HumbertoL/CoffeePotSensor/docs/HARDWARE.md

# Hardware Notes

This is everything known so far about the physical build: the parts, how they're wired and powered, and the plans for the next version. Anything not confirmed is marked *(unverified)*.

## Physical setup

As installed on 2026-10-14 (from the user's photos):

- **The pots:** three **BUNN airpots** (pump-action, with a lever on top), labeled **MEDIUM, DARK, DECAF from left to right**. They sit in a BUNN wire rack on the counter, against a tiled wall.
  - **Coffee is pumped out, so the pots stay on the rack while people pour.** A pot only leaves the rack to be refilled at the brewer, or to be cleaned. So any placement is a fresh pot (or one put back after cleaning), and no "minimum time off the rack" rule is needed.
  - **Cleaning happens after hours.** Putting a cleaned pot back looks exactly like a fresh pot, which is why the Slack messages only go out during the day (see README.md).
- **The device:** case v2 (`case/v2/`), mounted on the **wall behind the pots** (Velcro on the flat backs).
  - **Sensor bar:** low on the wall, just above the rack, behind the pots. Each sensor faces forward at the back of its pot, with its LEDs sticking out through the cover.
  - **Mast:** up the middle, behind the center pot. Its middle joint is wrapped in black tape.
  - **Head:** above the center pot, between the pump levers, at about eye level for someone at the counter. The screen's rows read Medium, Dark, Decaf top to bottom, matching the pots left to right.
  - **Power:** a USB-C cable out of the head's left side to a USB charger in the outlet to the left of the pots.
- **Wi-Fi:** right after install the screen showed the **offline** icon, but the board was online later that day (its first Slack post went out at 11:41 on 2026-10-14). ThingSpeak's `field5` (RSSI) shows the signal at that spot.

## Display: Waveshare 2inch LCD Module

[Wiki](https://www.waveshare.com/wiki/2inch-LCD-Module)

| | |
|---|---|
| Panel | IPS, 240×320, 262K colors |
| Driver | ST7789VW |
| Interface | 4-wire SPI (write-only, no MISO) |
| Operating voltage | 3.3 V or 5 V |
| Display area | 30.60 × 40.80 mm |
| Pixel pitch | 0.0975 mm |
| Module size | 58.0 × 35.0 mm, with standoffs at the four corners |
| Connectors | 8-pin header and an 8-pin cable connector, both carrying VCC, GND, DIN, CLK, CS, DC, RST, BL |

**How the firmware drives it** (`LCD_Driver.cpp`):
- **Orientation:** landscape, 320 × 240. The init command `0x36 = 0xA0` rotates the panel.
- **Color format:** 16-bit RGB565 (`0x3A = 0x05`).
- **Color inversion:** turned on (`0x21`). IPS panels need this for colors to come out right.
- **Backlight:** dimmed with PWM, set to `80`/255 (`BACKLIGHT` in `ui.cpp`).
- **SPI mode:** mode 3 at 20 MHz (`LCD_SPI_HZ` in `ui.cpp`). The ST7789 itself can go faster than that.
- **Drawing:** the code doesn't keep a copy of the screen in memory. Every pixel is written straight to the display.

## Microcontrollers

### Arduino Nano (retired)

No longer supported as of 2026-10-12. The notes below and the Nano wiring sections are kept as a record of the old build.

- The board is a **RobotDyn Nano V3**, a clone with a micro-USB port.
- ATmega328P chip at 16 MHz, with 2 KB of RAM and 32 KB of flash.
- Its pins run at 5 V, but the display expects 3.3 V. This is out of spec, but it works in practice.
- Its bootloader is unknown. Clones like this often have the old Nano bootloader, but this one isn't verified. That's why the idle restart avoids a watchdog reset; see CLAUDE.md.

### Waveshare ESP32-S3-Zero (current)

[Wiki](https://www.waveshare.com/wiki/ESP32-S3-Zero). It's also sold as the "ESP32-S3 Mini Development Board".

- **Chip:** ESP32-S3FH4R2, a dual-core 240 MHz processor with 4 MB of flash, 2 MB of PSRAM, Wi-Fi and BLE 5.
- **Size:** 18 × 23.5 mm board, with a 1.7 mm thick PCB. It comes without headers; solder on two 9-pin male strips at the standard 2.54 mm pitch.
- **USB:** native USB-C only, with no USB-to-serial chip. To force download mode, hold **BOOT** while plugging it in.
- **Pins are 3.3 V only and not 5 V tolerant.**
- **3V3(OUT):** this pin is fed by the onboard regulator, rated for up to 800 mA.
- **5V pin:** this is the USB 5V, passed straight through. It's an output when the board runs on USB, or an input if the board is powered from it instead. **In this project nothing connects to it.** The sensors and the LCD run on 3V3, and 5V must never reach a GPIO.
- **Onboard RGB LED:** a WS2812 on GPIO21.
- **Header pins vs. solder pads:** only some GPIOs are on the edge headers. As printed on the board, viewed face up with the USB-C on the right:
  - **Top edge**, left to right: 6, 5, 4, 3, 2, 1, 3V3, GND, 5V.
  - **Bottom edge**, left to right: 7, 8, 9, 10, 11, 12, 13, RX (43), TX (44).
  - **Solder pads only:** GP14–16 on the front; GP17, 18, 38–42 and 45 on the back.
- **Avoid:** GPIO0 and GPIO3 (they affect how the chip boots), 21 (the RGB LED), and 43/44 (the serial port).

## Wiring

| Signal | Nano | ESP32-S3-Zero |
|---|---|---|
| LCD VCC | 5V | 3V3(OUT) |
| LCD GND | GND | GND |
| LCD DIN (MOSI) | D11 | GPIO11 |
| LCD CLK (SCK) | D13 | GPIO12 |
| LCD CS | D10 | GPIO10 |
| LCD DC | D7 | GPIO9 |
| LCD RST | D8 | GPIO8 |
| LCD BL | D9 (PWM) | GPIO7 |
| Medium sensor OUT | D2 | GPIO4 |
| Dark sensor OUT | D3 | GPIO5 |
| Decaf sensor OUT | D4 | GPIO6 |
| Sensor VCC | 5V | **3V3 only** |
| Sensor GND | GND | GND |

On the ESP32-S3-Zero, all of these pins are on the edge headers, so none of the solder pads are needed. The display connects along the bottom edge (GP7–12). The sensors connect along the top edge (GP4–6), which also has 3V3 and GND.

### Swapping the Nano for the ESP32-S3-Zero (test)

ESP32-S3-Zero test wiring

This test reuses every wire from the current Nano build (see the next section) and only moves their ends.
- **Display:** the ribbon stays plugged into the LCD.
- **Sensor signals:** the three single wires move to GP4–6.
- **Power:**
  - The board has only one 3V3 pin and one GND pin, so power goes through the **Porcupine board** (below).
  - One female-to-female jumper runs from each ESP32 power pin to its rail, and everything that needs power plugs into the rail.
  - The white sensor wire moves from the Nano's 5V to the **3V3 rail**.

**Steps**
1. Solder the two 9-pin headers, with the pins pointing away from the BOOT/RESET buttons.
2. Move the wires as shown in the diagram. Two colors appear twice:
   - **Ribbon blue and yellow** go to the LCD: RST on GP8 and CLK on GP12.
   - **Single blue and yellow wires** go to the sensors: GP4 and GP5.
3. Leave **5V** empty. The IR modules pull their output up to their own supply, so on 5V they would put 5 V on GP4–6.
4. Flash the firmware over USB-C with board `esp32:esp32:waveshare_esp32_s3_zero`. If no `/dev/cu.usbmodem*` port appears, hold **BOOT** while plugging in.
5. Open the serial monitor at 115200 baud. Expect `[BOOT] Starting CoffeePot Monitor...`.
6. Check the screen:
   - The title and three rows appear.
   - Pots already present show **Unknown**.
   - A lifted pot shows **Removed** after about 3 seconds.
   - A pot put back starts its timer after about 1 second.
7. If detection got worse, re-tune each sensor's sensitivity screw. They have a shorter range at 3.3 V.

Expected draw on 3V3 is roughly 100–150 mA (backlight plus three sensors), well within the regulator's rating.

### Spider board (case v2)

In case v2, sensor power is split in the bar instead of the head, so only 5 wires go up the mast: 3 signals, 3V3 and GND.
- **What it is:** a second helper board in the bar, the "spider board".
- **Size:** 20 × 16.1 × 1.5 mm.
- **Pins:** two rows of 5 right-angle pins, one row per rail, pointing out of opposite ends.
- **3V3 row:** the mast's 3V3 plus each sensor's VCC.
- **GND row:** the mast's GND plus each sensor's GND.
- **The Porcupine board** in the head then feeds only the ESP32, the LCD and the mast.

See [case/v2/README.md](../case/v2/README.md).

### Porcupine board (power distribution)

This is a small helper board that turns the ESP32's single 3V3 pin and single GND pin into two 6-pin rails.
- **Construction:** a spare piece of prototype board, 13.8 mm wide (across the pin rows) × about 20 mm long, with two mounting holes.
- **Pins:** two rows of 6 male header pins on the top side.
- **Rails:** on the bottom, each row is soldered together into one rail, 3V3 or GND. All the wires already end in Dupont female housings, so nothing has to be cut.

| Rail | Pin 1 | Pin 2 | Pin 3 | Pins 4–6 |
|---|---|---|---|---|
| 3V3 | jumper from the ESP32's 3V3 | red (LCD VCC) | white (sensor VCC, via the existing lever connector) | spare |
| GND | jumper from the ESP32's GND | brown (LCD GND) | black (sensor GND, via the existing lever connector) | spare |

The spare pins fit each sensor's own VCC and GND, if the sensors are later taken off the lever connectors.

**Before first power-up:**
- Check with a multimeter that each rail is continuous across all 6 pins, and that the two rails aren't connected to each other.
- Mark the 3V3 rail. Swapping the rails would power the sensors and the LCD backwards.

**Future case work:** the case has no mount for this board yet. The redesigned brain box should include one.

## Old Nano build: wire colors (for reference)

This is the wiring as it is today, read from photos of the open case (October 2026) and checked against the pin assignments in the code. Each row says how it was determined:
- **Code + photo:** the photo clearly shows the wire on that pin, and it matches the code.
- **Photo:** traced in the photos, and consistent with the code, but not certain.
- **Builder:** confirmed by the person who wired it.
- **Inferred:** worked out from what's left over. Check with a continuity tester before relying on it.

### Board and connections

- **Board:** a RobotDyn Nano V3 (ATmega328P) mounted upside down, taped inside the center body.
- **Power:** a white micro-USB cable.
- **Connections:** all wires use individual Dupont female jumper housings on the Nano's headers. Nothing is soldered.
- **Sensor power:** it's shared through two orange-lever splice connectors, WAGO-style.

### Display (8-wire rainbow ribbon)

At the LCD end, the ribbon plugs into the module's 8-pin header with a single housing. The module's white cable connector is unused. Read top to bottom at the LCD, the colors are red, brown, orange, yellow, green, purple, blue, gray. That matches the header order VCC, GND, DIN, CLK, CS, DC, RST, BL.

| LCD pin | Wire | Nano pin | Source |
|---|---|---|---|
| VCC | red | 5V (analog-side row) | Code + photo |
| GND | brown | GND (digital-side row, next to RST) | Photo |
| DIN | orange | D11 | Photo |
| CLK | yellow | D13 | Code + photo |
| CS | green | D10 | Photo |
| DC | purple | D7 | Photo |
| RST | blue | D8 | Photo |
| BL | gray | D9 | Photo |

On the Nano end, DC, RST, BL, CS and DIN occupy D7–D11 as one group of housings, in that order from left to right: purple, blue, gray, green, orange. That order matches the LCD end exactly.

### Pot sensors (single-color jumper wires)

| Nano pin | Wire | Goes to | Pot in code | Source |
|---|---|---|---|---|
| D2 | blue | Left side box (as seen from the front) | Medium (`POT1_PIN`) | Photo |
| D3 | yellow | Center body sensor | Dark (`POT2_PIN`) | Photo |
| D4 | teal / green | Right side box (as seen from the front) | Decaf (`POT3_PIN`) | Photo |

- **Photo orientation:** the photos of the inside were taken from the back, with the doors off. Left and right in them are swapped compared with the front view.
- **Pot order:** the mapping above puts the pots left to right as Medium, Dark, Decaf, which matches the order on screen.
- **Exposed pins:** the Nano's digital-row GND and D2–D4 sit next to each other as one group of four housings: brown (LCD GND), blue, yellow, teal.

### Power distribution

| From | Wire | To | Source |
|---|---|---|---|
| USB | white micro-USB cable | Nano | Photo |
| 5V (analog-side row) | red (ribbon) | LCD VCC | Code + photo |
| GND (digital-side row) | brown (ribbon) | LCD GND | Photo |
| GND (analog-side row) | black | Sensor GND, via a lever splice connector | Inferred |
| ICSP header, 5V pin | white | Sensor 5V, via a lever splice connector | Builder (wired from a Nano pinout diagram; not measured) |

- **The ICSP white wire:** the analog-side 5V pin is already used by the LCD, so the white wire takes 5V from the ICSP header's 5V pin instead. The builder wired it following a Nano pinout diagram.
- **Sensor leads:** at least one side box sensor's leads are extended with Dupont jumpers. Red and black wires leave toward that box alongside its blue signal wire.
- **Free pins:** D5, D6, D12, A0–A7, and RX/TX (D0/D1). D12 (MISO) isn't needed because the LCD is write-only.

The splice connectors make shared 5V/GND easy. A cleanup could run one 5V and one GND from the Nano to a single splice each, with every sensor and the LCD branching off. That's the same idea as the rails on the planned sensor rod (see below).

## Pot sensors: IR reflection modules *(type inferred from the code)*

These are most likely FC-51 or TCRT5000-style IR obstacle modules. Each module has:
- an IR LED and a photodiode facing forward,
- an LM393 comparator chip,
- a sensitivity screw, and
- an indicator LED.

When enough IR bounces back, the comparator pulls OUT **LOW**. The firmware treats LOW as "pot present".

- **Power:** 3.3–5 V. On the ESP32 they **must** run from 3V3. The module's output pull-up goes to its own supply voltage, so at 5 V it would put 5 V on the ESP32's pins. At 3.3 V the range is a little shorter, so re-tune the sensitivity screw.
- **Current:** about 20–30 mA each, mostly the LEDs. Three of them draw well under 100 mA.
- **Pull-up:** the module has one built in, so the pins are plain `INPUT`.
- **Reliability caveats:**
  - Readings depend on the pot's surface: glass, shiny steel and dark plastic all reflect differently.
  - They also depend on distance and angle, and on ambient IR such as sunlight.
  - A sensor tuned right at its threshold will flicker.
- **Firmware debounce:** a pot counts as placed after 1 s of steady "present", and as removed after 3 s of steady "absent". A hand passing by or a brief dropout won't reset the timer.

## Firmware behavior that depends on the hardware

- **Power-on:** a pot already on the rack at power-on shows **?**. Its timer starts the next time it's put back, or when its time is restored from the dashboard.
- **Idle restart:** with no pot activity for 48 h (a weekend), the device restarts itself.
- **ESP32 watchdog:** the ESP32 also has a hardware watchdog that reboots it if the firmware hangs.
