HumbertoL/CoffeePotSensor/case/v2/renders/plate_layout.png

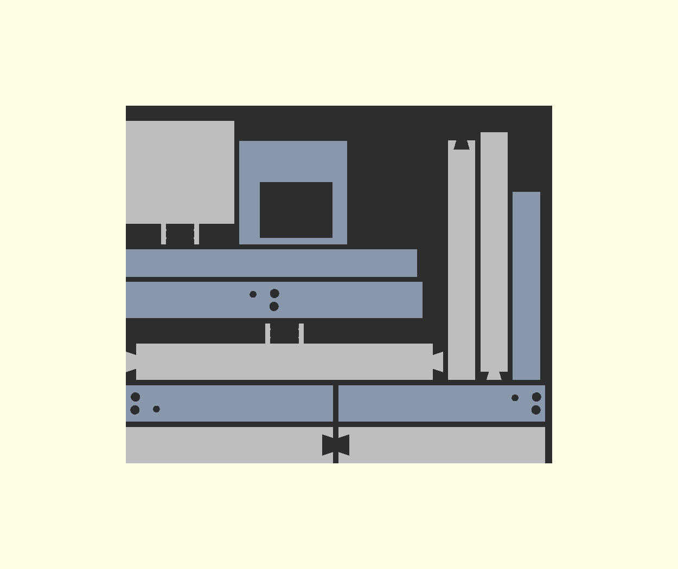
case/v2/renders/plate_layout.png
