HumbertoL/CoffeePotSensor/case/v2/renders/plate_layout_3d.png

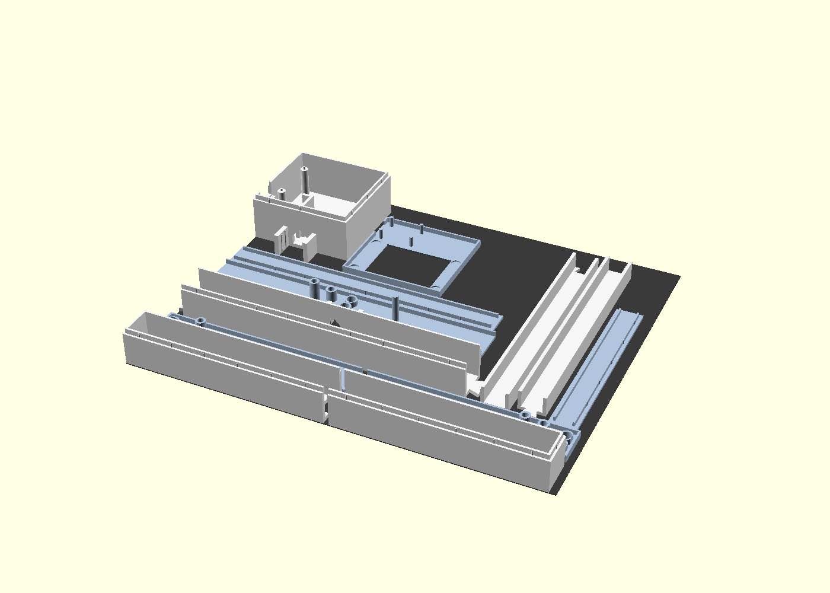
case/v2/renders/plate_layout_3d.png
