HumbertoL/CoffeePotSensor/case/coffee timer.SLDASM

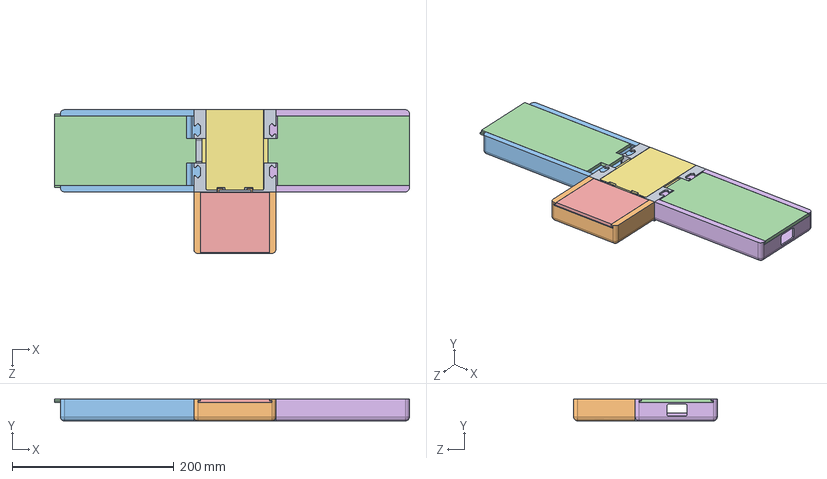
[picture p10: CAD file, 2026-10-09]
case/coffee timer.SLDASM
439.0 x 27.0 x 178.0 mm
coffee timer-002
coffee timer-003
coffee timer-001
coffee timer-004 x 2
coffee timer-005
Mirrorcoffee timer-001
coffee timer-007
