HumbertoL/CoffeePotSensor/case/coffee timer - coffee timer-005-1.STL

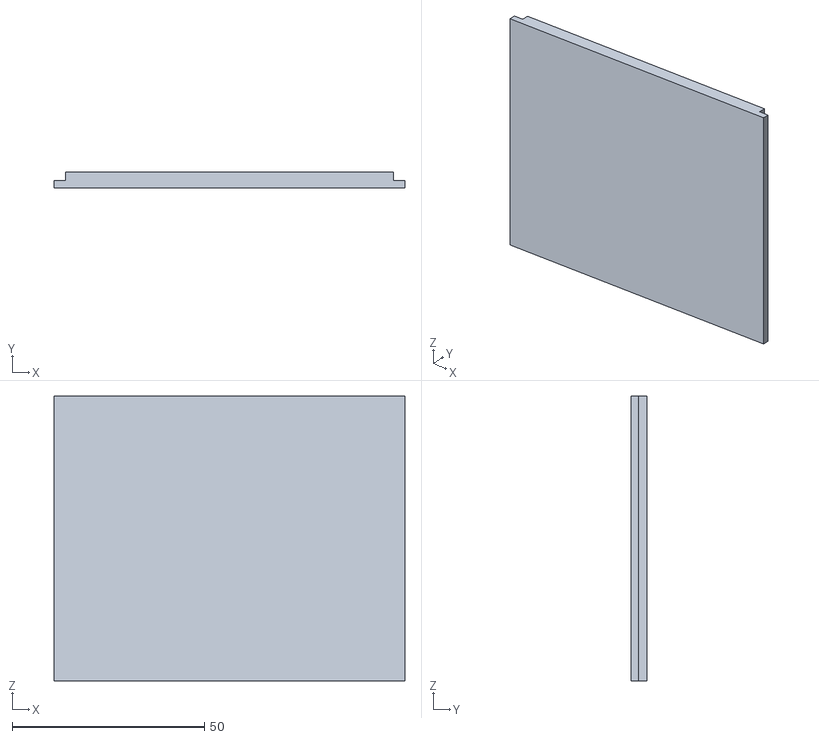
[picture p11: CAD file, 2026-10-09]
case/coffee timer - coffee timer-005-1.STL
91.4 x 4.20 x 74.2
