HumbertoL/CoffeePotSensor/case/coffee timer - coffee timer-001-1.STL

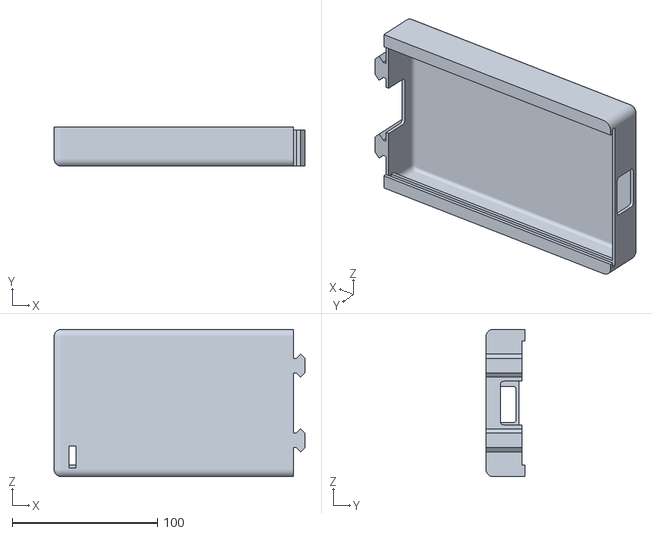
[picture p12: CAD file, 2026-10-09]
case/coffee timer - coffee timer-001-1.STL
173.1 x 27.0 x 101.6
