HumbertoL/CoffeePotSensor/case/coffee timer-003-display.STL

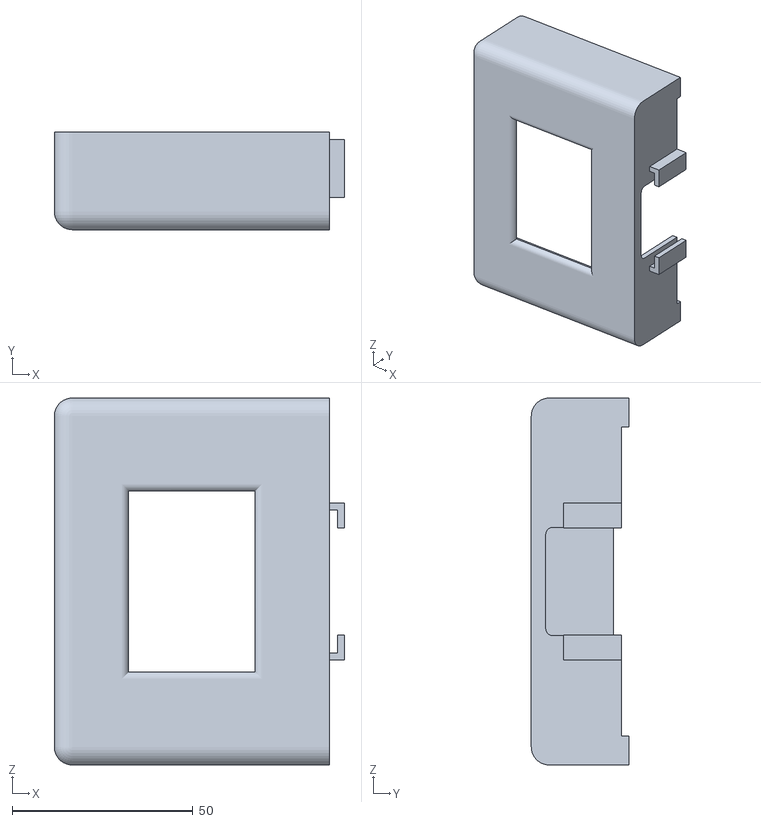
[picture p13: CAD file, 2026-10-09]
case/coffee timer-003-display.STL
80.4 x 27.0 x 101.6
