HumbertoL/CoffeePotSensor/case/coffee timer-007.SLDPRT

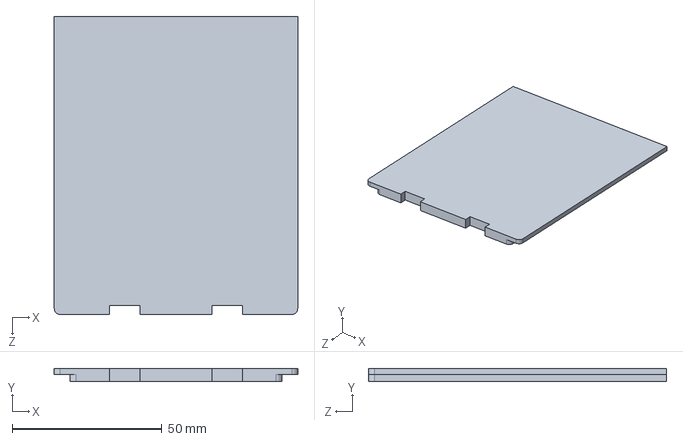
[picture p14: CAD file, 2026-10-09]
case/coffee timer-007.SLDPRT
81.4 x 4.20 x 99.6 mm
