HumbertoL/CoffeePotSensor/case/coffee timer-006.SLDPRT

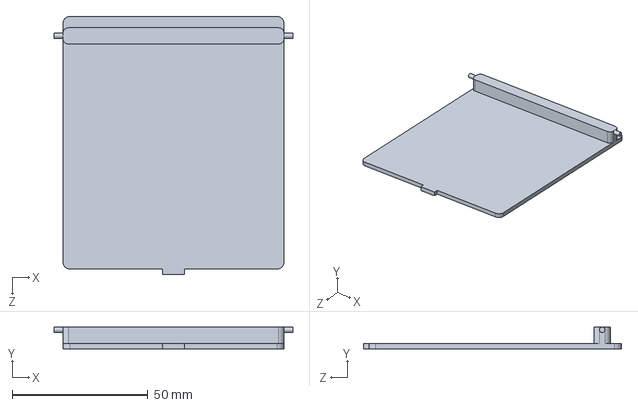
[picture p15: CAD file, 2026-10-09]
case/coffee timer-006.SLDPRT
88.0 x 8.00 x 95.0 mm
