HumbertoL/CoffeePotSensor/case/coffee timer-004-side-door.STL

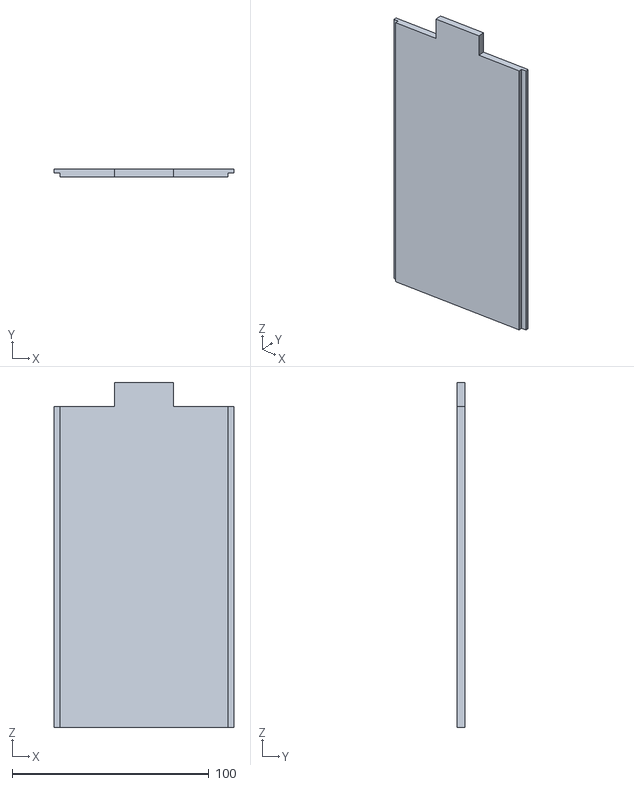
[picture p16: CAD file, 2026-10-09]
case/coffee timer-004-side-door.STL
91.4 x 4.20 x 175.3
