HumbertoL/CoffeePotSensor/case/coffee timer-002.SLDPRT

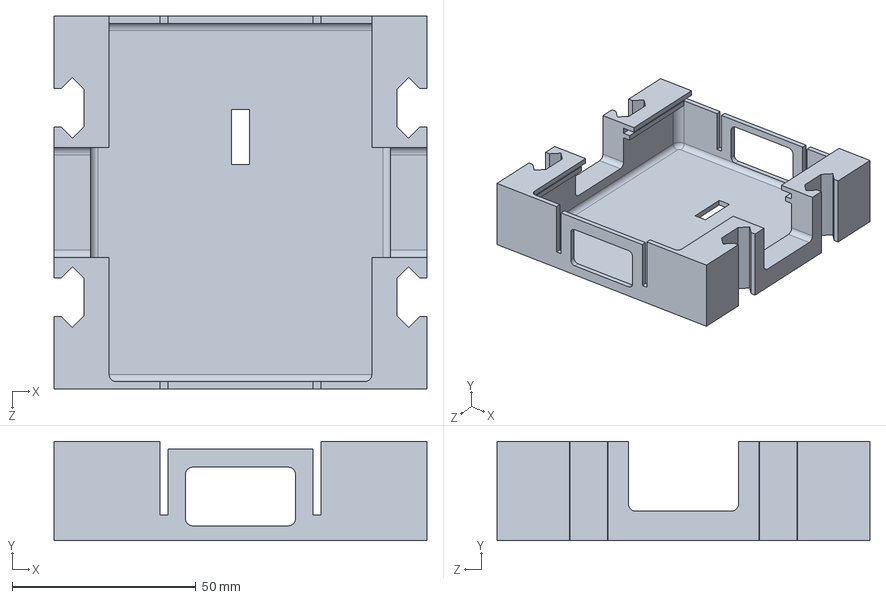
[picture p17: CAD file, 2026-10-09]
case/coffee timer-002.SLDPRT
101.6 x 27.0 x 101.6 mm
