HumbertoL/CoffeePotSensor/case/coffee timer - coffee timer-004-1.STL

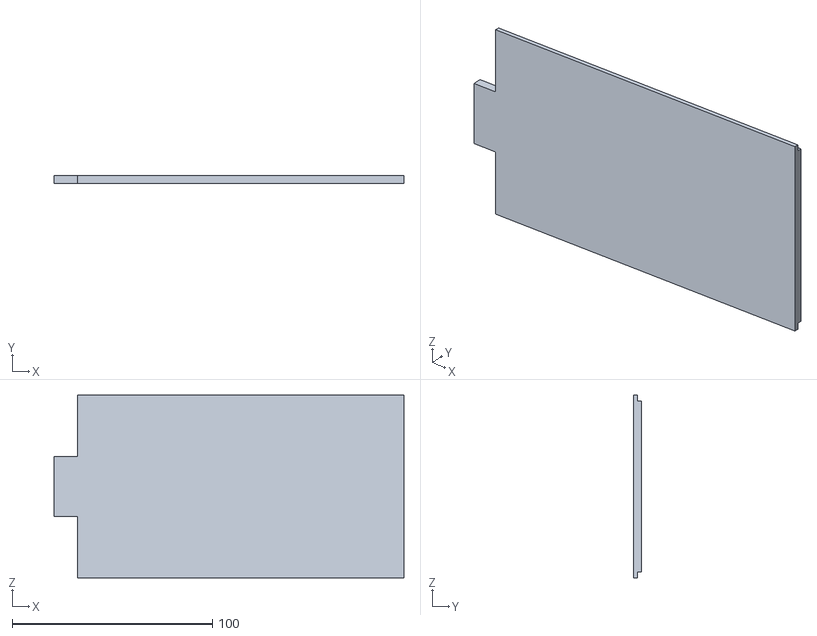
[picture p18: CAD file, 2026-10-09]
case/coffee timer - coffee timer-004-1.STL
174.9 x 4.20 x 91.4
