HumbertoL/CoffeePotSensor/case/coffee timer-002-center.STL

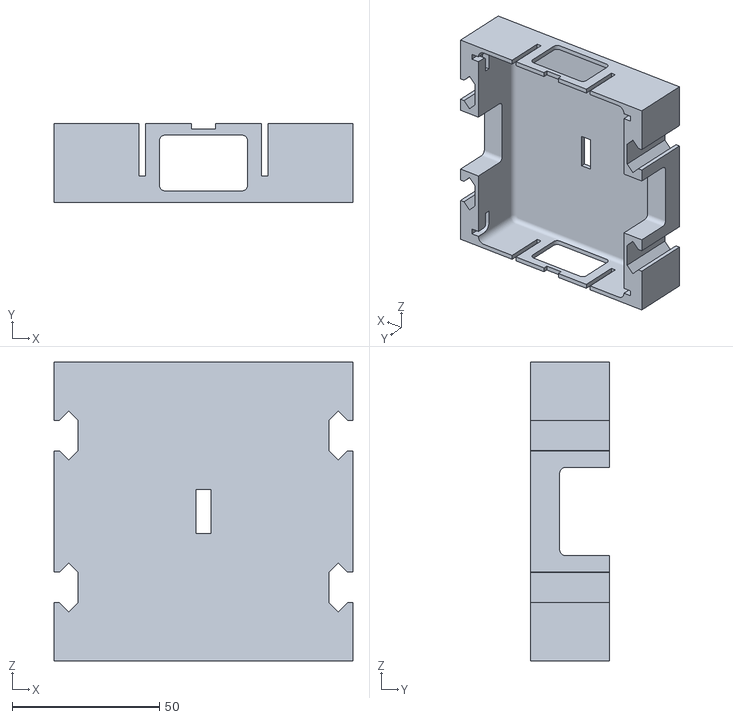
[picture p19: CAD file, 2026-10-09]
case/coffee timer-002-center.STL
101.6 x 27.0 x 101.6
