HumbertoL/CoffeePotSensor/(list of files, cad)

Other CAD files:
case/coffee timer-005-display-door.STL
case/coffee timer - coffee timer-002-1.STL
case/coffee timer-001.SLDPRT
case/coffee timer-003.SLDPRT
case/coffee timer-006-center-door.STL
case/coffee timer - coffee timer-003-1.STL
case/Mirrorcoffee timer-001.SLDPRT
case/coffee timer - coffee timer-004-2.STL
case/coffee timer-001-side.STL
case/coffee timer - Mirrorcoffee timer-001-3.STL
case/coffee timer-004.SLDPRT
case/coffee timer-005.SLDPRT
case/coffee timer - coffee timer-007-1.STL
