HumbertoL/CoffeePotSensor/case/v2/renders/joint_test_assembled.png

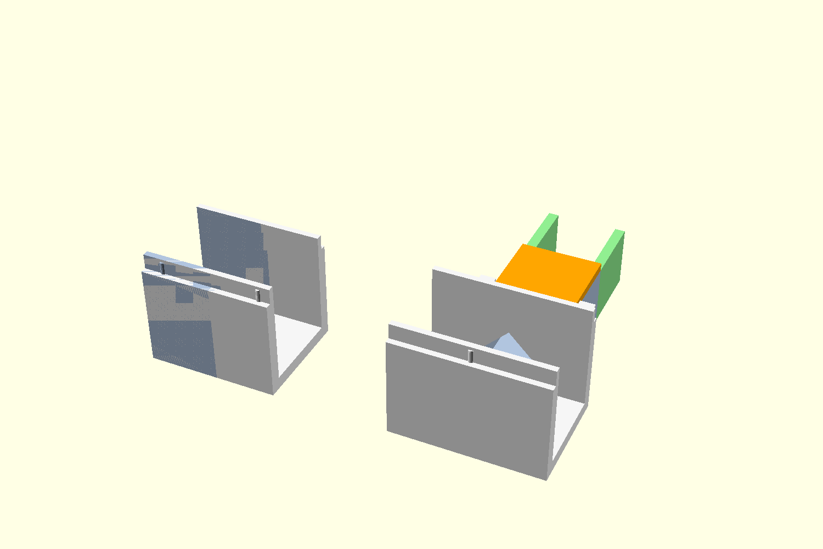
case/v2/renders/joint_test_assembled.png
