HumbertoL/CoffeePotSensor/case/v2/renders/joint_test.png

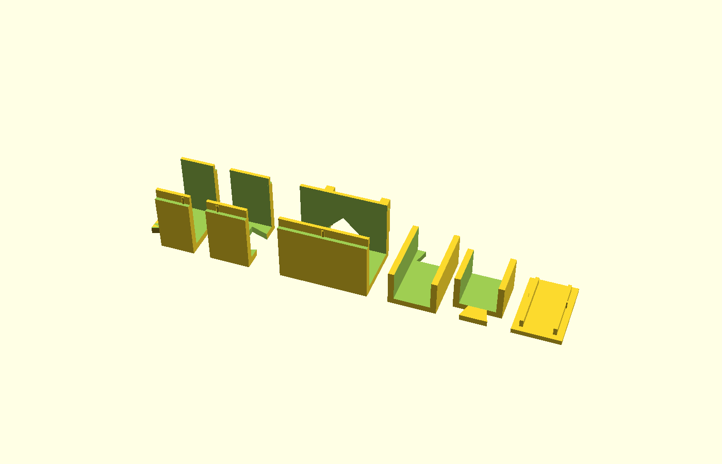
case/v2/renders/joint_test.png
