HumbertoL/CoffeePotSensor/case/v2/renders/joint_test_back.png

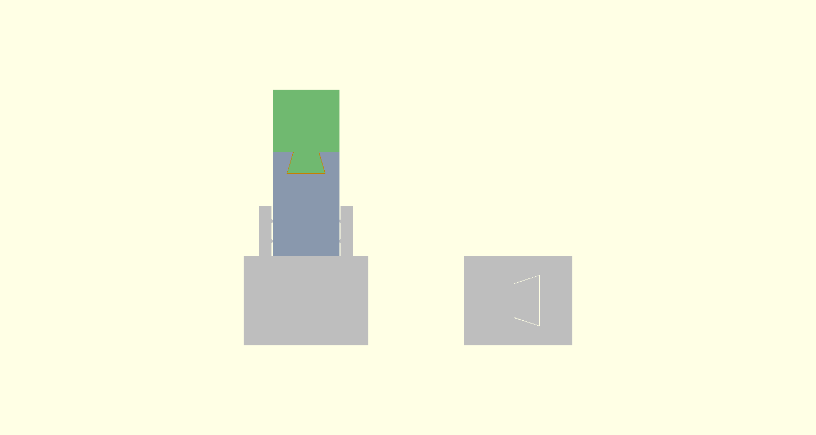
case/v2/renders/joint_test_back.png
