HumbertoL/CoffeePotSensor/case/v2/renders/joint_test_exploded.png

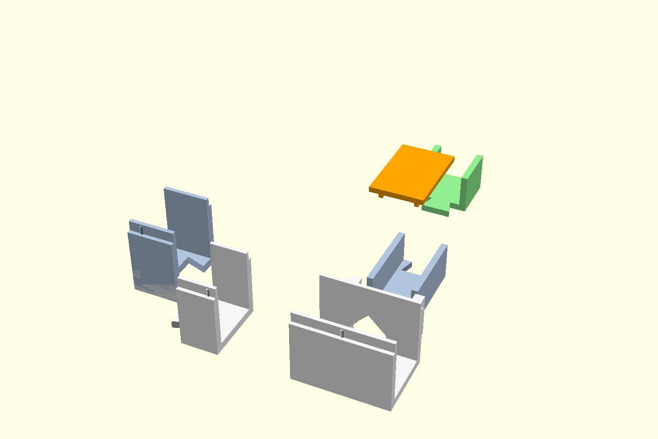
case/v2/renders/joint_test_exploded.png
