HumbertoL/CoffeePotSensor/CoffeePotSensor.ino

// brew-em-all: shows how long each of three coffee pots has been on the rack.
// Runs on a Waveshare ESP32-S3-Zero with a Waveshare 2" ST7789 LCD (see README.md).
#include "publish.h"  // ThingSpeak (credentials in secrets.h)
#include "ui.h"       // the screen (LovyanGFX)
#include "ota.h"      // firmware updates over Wi-Fi
#include <time.h>
#include <esp_system.h>

#if !defined(ARDUINO_ARCH_ESP32)
#error "brew-em-all runs on the ESP32-S3-Zero only (Nano support was dropped)"
#endif

#define POT1_PIN 4  // GPIO numbers on the ESP32-S3-Zero (3.3V inputs only!)
#define POT2_PIN 5
#define POT3_PIN 6
#define REFRESH_INTERVAL 100UL  // ms between sensor polls
// Sensor test mode: set to 1 to show raw readings with no debounce and log each change to Serial.
// For checking a sensor or case print; set it back to 0 for normal use. Nothing is published in this mode.
#define SENSOR_TEST 0
#if SENSOR_TEST
#define PLACE_DEBOUNCE_MS 0UL
#define REMOVE_DEBOUNCE_MS 0UL
#else
#define PLACE_DEBOUNCE_MS 1000UL   // sensor must read "present" this long before a pot counts as placed
#define REMOVE_DEBOUNCE_MS 3000UL  // ...or "absent" this long before it counts as removed (ignores IR flicker)
#endif
#define IDLE_RESTART_MS (48UL * 60 * 60 * 1000)  // restart after this long with no pot activity (e.g. over a weekend)
#define HEARTBEAT_MS (30UL * 60 * 1000)  // a ThingSpeak entry at least this often (signal, memory, uptime)

// Slack "fresh pot" messages (SLACK_WEBHOOK_URL in secrets.h): only for pots placed on these
// days, between these times (local time, TIME_ZONE in publish.cpp). Outside that, a placed pot
// is usually one put back after cleaning, so it's not announced.
#define SLACK_DAYS ((1 << 2) | (1 << 3) | (1 << 5))   // bits by tm_wday (0 = Sunday): Tue, Wed, Fri
#define SLACK_FROM_MIN (8 * 60)          // 8:00 am
#define SLACK_UNTIL_MIN (17 * 60 + 30)   // 5:30 pm

unsigned long lastUpdate = 0;
unsigned long lastActivity = 0;  // millis() of the last pot placed/removed (or boot)
unsigned long lastHeartbeat = 0;

struct CoffeePot {
  const char* name;
  int sensorPin;
  bool present;               // debounced state
  bool rawPresent;            // latest sensor reading
  unsigned long rawChangedAt; // millis() when rawPresent last changed
  bool timeKnown;  // false until the pot has been placed while we were watching
  unsigned long placedAt;
};

const char* const potNames[3] = { "Medium", "Dark", "Decaf" };  // top to bottom on the screen

CoffeePot pots[3] = {
  { potNames[0], POT1_PIN, false, false, 0, false, 0 },
  { potNames[1], POT2_PIN, false, false, 0, false, 0 },
  { potNames[2], POT3_PIN, false, false, 0, false, 0 }
};


bool isPotPresent(const CoffeePot& pot) {
  return digitalRead(pot.sensorPin) == LOW;
}

// Restart from scratch: millis() starts over and setup() runs again
// (which also resets the LCD).
// Why the board restarted itself, kept across the restart (RTC memory survives a
// software reset), so the "Started" note can say so
#define RESTART_MAGIC 0xB0071E55
enum RestartWhy : uint8_t { WHY_IDLE = 1, WHY_UPDATE = 2 };
struct RestartNote {
  uint32_t magic;
  uint8_t why;
  int32_t fromVersion;   // WHY_UPDATE: the version before the update
};
RTC_NOINIT_ATTR RestartNote restartNote;

void noteRestart(uint8_t why) {   // a RestartWhy (uint8_t: the .ino's auto-prototypes come before the enum)
  restartNote.why = why;
  restartNote.fromVersion = FIRMWARE_VERSION;
  restartNote.magic = RESTART_MAGIC;
}

void restart() {
  Serial.println(F("[debug] No pot activity, restarting..."));
  noteRestart(WHY_IDLE);
  Serial.flush();
  ESP.restart();
}

// Pots' ages kept across a restart into new firmware (RTC memory survives a software
// reset). Only the update path writes it; the weekend idle restart starts fresh.
#define SAVED_MAGIC 0xC0FFEE01
struct SavedPots {
  uint32_t magic;
  int8_t state[3];
  time_t placedEpoch[3];   // Unix time each POT_KNOWN pot was placed
};
RTC_NOINIT_ATTR SavedPots savedPots;
bool restorePending = false;

void savePotsForRestart() {
  noteRestart(WHY_UPDATE);
  if (!clockValid()) return;   // no clock: the ages can't be carried over
  time_t epoch = time(nullptr);
  unsigned long now = millis();
  for (int i = 0; i < 3; ++i) {
    savedPots.state[i] = !pots[i].present ? POT_REMOVED : pots[i].timeKnown ? POT_KNOWN : POT_UNKNOWN;
    savedPots.placedEpoch[i] = epoch - (time_t)((now - pots[i].placedAt) / 1000);
  }
  savedPots.magic = SAVED_MAGIC;
}

// Once the clock is set after an update restart, give back the ages of the pots
// that are still on the rack
void restorePots(unsigned long now) {
  if (!restorePending || !clockValid()) return;
  restorePending = false;
  time_t epoch = time(nullptr);
  bool any = false;
  for (int i = 0; i < 3; ++i) {
    if (savedPots.state[i] != POT_KNOWN || !pots[i].present || pots[i].timeKnown) continue;
    if (savedPots.placedEpoch[i] > epoch) continue;
    pots[i].placedAt = now - (unsigned long)(epoch - savedPots.placedEpoch[i]) * 1000UL;
    pots[i].timeKnown = true;
    any = true;
  }
  if (any) publishState("Ages restored after update");
}

// A command from the dashboard (ThingSpeak TalkBack):
//   SET <pot 1-3> <Unix time>   the pot was placed at that time (restoring its age after a
//                               restart, or entering it by hand). Only for a pot on the rack.
void handleCommand(const char* cmd, unsigned long now) {
  int pot = 0;
  long long placed = 0;
  char note[48];
  if (sscanf(cmd, "SET %d %lld", &pot, &placed) != 2 || pot < 1 || pot > 3) {
    Serial.printf("[talkback] unknown command \"%s\"\n", cmd);
    return;
  }
  CoffeePot& p = pots[pot - 1];
  time_t epoch = time(nullptr);
  if (!clockValid()) {
    snprintf(note, sizeof(note), "%s time not set (no clock yet)", p.name);
  } else if (!p.present) {
    snprintf(note, sizeof(note), "%s time not set (not on the rack)", p.name);
  } else if (placed > epoch + 60 || epoch - placed > 49LL * 24 * 3600) {
    snprintf(note, sizeof(note), "%s time not set (out of range)", p.name);
  } else {
    unsigned long ageMs = placed >= epoch ? 0 : (unsigned long)(epoch - placed) * 1000UL;
    p.placedAt = now - ageMs;
    p.timeKnown = true;
    snprintf(note, sizeof(note), "%s time set", p.name);
  }
  Serial.printf("[talkback] %s\n", note);
  publishState(note);
}

// Posts "Fresh pot" to Slack for a pot just placed, if it's within the Slack days and hours
void announceFreshPot(const CoffeePot& pot, unsigned long now) {
#if !SENSOR_TEST
  if (!clockValid()) return;
  time_t placed = time(nullptr) - (time_t)((now - pot.placedAt) / 1000);
  struct tm t;
  localtime_r(&placed, &t);
  int minute = t.tm_hour * 60 + t.tm_min;
  if (!(SLACK_DAYS & (1 << t.tm_wday)) || minute < SLACK_FROM_MIN || minute >= SLACK_UNTIL_MIN) return;
  char when[12], text[96];
  strftime(when, sizeof(when), "%l:%M %p", &t);
  const char* w = when;
  while (*w == ' ') ++w;   // "%l" pads the hour with a space
  snprintf(text, sizeof(text), ":coffee: Fresh pot of *%s* on the rack (brewed %s)", pot.name, w);
  publishSlack(pot.name, text);
#endif
}

// Why the board last restarted, for the "Started" note (a crash loop shows up on the dashboard)
const char* resetReasonText() {
  switch (esp_reset_reason()) {
    case ESP_RST_POWERON: return "power-on";
    case ESP_RST_SW: return "restart";
    case ESP_RST_PANIC: return "crash";
    case ESP_RST_INT_WDT:
    case ESP_RST_TASK_WDT:
    case ESP_RST_WDT: return "watchdog";
    case ESP_RST_BROWNOUT: return "brownout";
    case ESP_RST_USB: return "USB";
    default: return "other";
  }
}

// Each pot's state, for the screen and ThingSpeak
void potReports(PotReport reports[3], unsigned long now) {
  for (int i = 0; i < 3; ++i) {
    reports[i].state = !pots[i].present ? POT_REMOVED : pots[i].timeKnown ? POT_KNOWN : POT_UNKNOWN;
    reports[i].ageMs = now - pots[i].placedAt;
  }
}

// Sends all three pots to ThingSpeak, with a note on what changed
void publishState(const char* status) {
#if !SENSOR_TEST
  lastHeartbeat = millis();   // any entry counts as the heartbeat
  PotReport reports[3];
  potReports(reports, millis());
  publishPots(reports, status);
#endif
}

void setup() {
  // Hardware watchdog: reboots the board if loop() ever stops returning (a real hang)
  enableLoopWDT();
  Serial.begin(115200);
  Serial.println(F("\n[BOOT] Starting brew-em-all..."));
  uiBegin();

  pinMode(POT1_PIN, INPUT);
  pinMode(POT2_PIN, INPUT);
  pinMode(POT3_PIN, INPUT);

  // A pot already on the rack at power-on has an unknown age. Recording it as
  // present means the timer only starts once it's removed and put back.
  for (int i = 0; i < 3; ++i) {
    pots[i].present = pots[i].rawPresent = isPotPresent(pots[i]);
  }
  // After an update, the pots still on the rack get their ages back once the clock is set
  restorePending = esp_reset_reason() == ESP_RST_SW && savedPots.magic == SAVED_MAGIC;
  savedPots.magic = 0;

  publishBegin();
  otaBegin();
  // "Updated v38 → v39" after an update, "Started v39 (idle restart)" after the weekend
  // restart, otherwise "Started v39 (power-on)" and so on
  char status[40];
  bool noted = esp_reset_reason() == ESP_RST_SW && restartNote.magic == RESTART_MAGIC;
  if (noted && restartNote.why == WHY_UPDATE) {
    snprintf(status, sizeof(status), "Updated v%ld \u2192 v%d", (long)restartNote.fromVersion, FIRMWARE_VERSION);
  } else {
    snprintf(status, sizeof(status), "Started v%d (%s)", FIRMWARE_VERSION,
             noted && restartNote.why == WHY_IDLE ? "idle restart" : resetReasonText());
  }
  restartNote.magic = 0;
  Serial.printf("[BOOT] %s\n", status);
  publishState(status);
}

void updatePotStatus(CoffeePot& pot, unsigned long now) {
  bool raw = isPotPresent(pot);
  if (raw != pot.rawPresent) {
    pot.rawPresent = raw;
    pot.rawChangedAt = now;
#if SENSOR_TEST
    Serial.print(pot.name);
    Serial.println(raw ? F(": present") : F(": absent"));
#endif
  }

  // Only accept a change once the reading has held steady long enough
  if (raw == pot.present) {
    return;
  }
  unsigned long debounce = raw ? PLACE_DEBOUNCE_MS : REMOVE_DEBOUNCE_MS;
  if (now - pot.rawChangedAt < debounce) {
    return;
  }

  lastActivity = now;
  if (raw) {
    // Start the timer from when the pot actually arrived, not when the debounce finished
    pot.placedAt = pot.rawChangedAt;
    pot.timeKnown = true;
  }
  pot.present = raw;
  if (raw) announceFreshPot(pot, now);

  char status[24];
  snprintf(status, sizeof(status), "%s %s", pot.name, raw ? "placed" : "removed");
  publishState(status);
}

void loop() {
  unsigned long now = millis();
  if (!lastUpdate || now - lastUpdate >= REFRESH_INTERVAL) {
    lastUpdate = now;

    // Nobody has touched a pot in a long time (a weekend), so start fresh.
    // Pots still on the rack will show "Unknown" afterwards.
    if (now - lastActivity >= IDLE_RESTART_MS) {
      restart();
    }

    restorePots(now);
    for (int i = 0; i < 3; ++i) {
      updatePotStatus(pots[i], now);
    }
    char cmd[64];
    while (publishTakeCommand(cmd, sizeof(cmd))) {
      handleCommand(cmd, now);
    }
    while (publishTakeNote(cmd, sizeof(cmd))) {
      publishState(cmd);   // e.g. "Slack: Dark posted"
    }
    if (now - lastHeartbeat >= HEARTBEAT_MS) {
      lastHeartbeat = now;
      publishState("");    // no note: the activity list skips it
    }
    PotReport reports[3];
    potReports(reports, now);
    uiDraw(potNames, reports, publishNetState());
  }
}
