HumbertoL/CoffeePotSensor/DEV_Config.h

/*****************************************************************************
* | File        :   DEV_Config.c
* | Author      :   Waveshare team
* | Function    :   Hardware underlying interface
* | Info        :
*                Used to shield the underlying layers of each master 
*                and enhance portability
*----------------
* | This version:   V1.0
* | Date        :   2018-11-22
* | Info        :

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
******************************************************************************/
#ifndef _DEV_CONFIG_H_
#define _DEV_CONFIG_H_

#include <stdint.h>
#include <stdio.h>
#include <SPI.h>
#include "Debug.h"
#include <Arduino.h>  // PROGMEM / pgm_read_byte on both AVR and ESP32



#define UBYTE   uint8_t
#define UWORD   uint16_t
#define UDOUBLE uint32_t

/**
 * GPIO config
**/

#if defined(ARDUINO_ARCH_ESP32)
// Waveshare ESP32-S3-Zero (GPIO numbers). The core's default SPI pins
// (GPIO34-37) aren't on the headers, so SPI is routed to GPIO11/12 explicitly.
#define DEV_CS_PIN   10
#define DEV_DC_PIN   9
#define DEV_RST_PIN  8
#define DEV_BL_PIN   7
#define DEV_MOSI_PIN 11
#define DEV_SCK_PIN  12
#define DEV_SPI_HZ   20000000  // safe for jumper wires; the ST7789 can go faster
#else
// Arduino Nano / UNO (MOSI = D11, SCK = D13 are fixed by the hardware SPI)
#define DEV_CS_PIN  10
#define DEV_DC_PIN  7
#define DEV_RST_PIN 8
#define DEV_BL_PIN  9
#define DEV_SPI_HZ  8000000  // F_CPU / 2, the fastest the Nano can do
#endif


/**
 * GPIO read and write
**/
#define DEV_Digital_Write(_pin, _value) digitalWrite(_pin, _value == 0? LOW:HIGH)
#define DEV_Digital_Read(_pin) digitalRead(_pin)


/**
 * SPI
**/
#define DEV_SPI_WRITE(_dat)   SPI.transfer(_dat)

/**
 * delay x ms
**/
#define DEV_Delay_ms(__xms)    delay(__xms)

/**
 * PWM_BL
**/
 #define  DEV_Set_PWM(_Value)  analogWrite(DEV_BL_PIN, _Value)

/*-----------------------------------------------------------------------------*/
 void Config_Init();
#endif
