HumbertoL/CoffeePotSensor/thingspeak_root_ca.h

// Root certificates the board trusts when publishing to api.thingspeak.com over
// HTTPS (copied from office_ac_controller). Checked 2026-10-02: *.thingspeak.com is
// issued by DigiCert Global G2 TLS RSA SHA256 2020 CA1, under DigiCert Global Root G2
// (the first one below). The others are major public roots, kept in case
// ThingSpeak changes certificate authority:
//   DigiCert Global Root G2, Amazon Root CA 1, USERTrust RSA (Sectigo),
//   GlobalSign Root R3 (valid to 2029), Starfield G2, Go Daddy G2, ISRG Root X1.
// The others are valid to 2035-2038.
// If none of them match, publishing fails with a connection error on Serial.
// Then find the right root with:
//   openssl s_client -connect api.thingspeak.com:443 -servername api.thingspeak.com -showcerts
// and add it here.
#pragma once

const char* TS_ROOT_CA = R"PEM(
-----BEGIN CERTIFICATE-----
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
MrY=
-----END CERTIFICATE-----
-----BEGIN CERTIFICATE-----
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
rqXRfboQnoZsG4q5WTP468SQvvG5
-----END CERTIFICATE-----
-----BEGIN CERTIFICATE-----
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
jjxDah2nGN59PRbxYvnKkKj9
-----END CERTIFICATE-----
-----BEGIN CERTIFICATE-----
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
WD9f
-----END CERTIFICATE-----
-----BEGIN CERTIFICATE-----
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
-----END CERTIFICATE-----
-----BEGIN CERTIFICATE-----
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
4uJEvlz36hz1
-----END CERTIFICATE-----
-----BEGIN CERTIFICATE-----
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
-----END CERTIFICATE-----
)PEM";
