HumbertoL/CoffeePotSensor/(commit log)

2025-07-09 pef: speed up lcd by using driver directly
2026-10-09 docs: add CLAUDE.md, sensor wiring and build instructions
    - Add CLAUDE.md with build commands, file layout, architecture and gotchas
    - Document pot sensor pins and active-LOW wiring in README
    - Add building & flashing section to README
    - Fix misleading REFRESH_INTERVAL comment
2026-10-09 fix: stop clock overflow redraws and show Unknown after power cycle
    - Replace 16-bit lastElapsedSeconds (overflowed after ~9h, causing a
    redraw every loop) with a fixed-width status string compare
    - Drop String usage so the sketch no longer touches the heap
    - Fix sprintf format/argument size mismatch for seconds
    - Pots present at power-on show "Unknown" until removed and replaced
    - Update CLAUDE.md and README for the new behavior
2026-10-09 feat: idle restart after 48h and port to ESP32-S3-Zero
    - Restart the device after 48h with no pot placed/removed (e.g. weekends);
    jmp 0 on AVR (safe with old Nano bootloader), ESP.restart() on ESP32
    - Add Waveshare ESP32-S3-Zero support: per-arch pins and SPI setup,
    explicit SPI pins (core defaults aren't on the headers), loop watchdog
    - Replace avr/pgmspace.h with Arduino.h and move it out of extern "C"
    - Drop ESP8266 support
    - Update README and CLAUDE.md with ESP32-S3 wiring and build steps
2026-10-09 feat: debounce pot sensors; docs: add hardware notes and future work
    - Debounce IR sensor readings (1 s to place, 3 s to remove) so brief
    flickers don't reset the timer; time placements from the first reading
    - Add docs/HARDWARE.md: display specs, ESP32-S3-Zero pins/pads, wiring,
    IR sensor behavior, and the planned sensor rod + brain box redesign
    - Add docs/FUTURE_WORK.md: time-of-flight sensors and OTA updates
    - Link new docs from README and CLAUDE.md
2026-10-09 feat: add OpenSCAD conversion of the case, with SolidWorks and STL sources
    - case/scad: one parametric OpenSCAD file per part plus assembly.scad,
    reverse-engineered from the SolidWorks STL exports (whole assembly
    matches within 0.1% by volume)
    - Left side door fully inserted in the assembly; side box wire hole
    rounded to whole mm and centered
    - case/tools: slice.py / compare.py used to measure and verify the models
    - Include the original SolidWorks parts/assembly and STL exports so they
    are preserved in history
    - Ignore STL files and .DS_Store going forward
2026-10-09 chore: remove SolidWorks and STL files, keep only the OpenSCAD case
    The OpenSCAD models in case/scad are now the source of truth. The
    original SolidWorks parts/assembly and STL exports remain in history at
    e428796 (restore with `git checkout e428796 -- case`) and are now
    git-ignored. Docs updated to point there.
2026-10-09 docs: add fresh-pot animation to future work
    Covers Nano vs ESP32-S3 feasibility, GIF (AnimatedGIF) vs MJPEG (JPEGDEC),
    and the two display-driver options: a block-write function in the existing
    Waveshare driver, or switching to LovyanGFX / TFT_eSPI.
2026-10-12 docs: document current Nano wiring colors
    Add the LCD ribbon, sensor and power wire colors for the current Nano
    build (traced from photos, checked against the code), mark how each was
    determined, record the board as a RobotDyn Nano V3, and note the sensors
    take 5V from the ICSP header.
2026-10-12 docs: add ESP32-S3-Zero swap wiring diagram and test steps
    - docs/esp32-wiring.svg: wiring for replacing the Nano with the
    ESP32-S3-Zero, reusing the existing wires (3V3/GND via splices, 5V empty)
    - HARDWARE.md: board size, 5V pin behavior, pin layout as silkscreened,
    and step-by-step swap/test instructions
2026-10-12 docs: use the power distribution board for 3V3/GND in the ESP32 swap
    Replace the splice connectors in the swap instructions and wiring diagram
    with the 2x6-pin helper board (one 3V3 rail, one GND rail), document its
    pin assignments and pre-power-up checks.
2026-10-12 feat: add case v2 (sensor bar, mast, and head) in OpenSCAD
    A redesigned, screwless case for the ESP32-S3-Zero build: a 3-segment
    sensor bar (FC-51s on posts, hooded LED bores, tuning holes), a 2-piece
    printed mast carrying the 9 wires, and a head holding the LCD, ESP32 and
    power board with USB-C on the left. Screen height is one parameter
    (screen_h, default 12.5 in). Flat backs for Velcro; covers are the fronts.
    All parts print without supports and fit the MK4S bed. Boards and wires
    are drawn in preview only and never end up in an STL. Includes test-print
    parts (sensor_test, esp_test), renders, and a README with measurements
    and their confidence.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
2026-10-12 feat: case v2 spider board, 5-wire mast, routed wires, tighter covers
    - Add a holder for the "spider" board (2x5 right-angle pins) in the bar's
    center segment, so sensor power splits in the bar and only 5 wires
    (3 signals, 3V3, GND) go up the mast
    - Draw every wire along its planned route in preview
    - Tighten cover fit after the first sensor_test print was loose:
    cover_clr 0.2 -> 0.1, rib 0.3 -> 0.35, crush ribs every 20 mm
    - List all PART options next to PART
    - Rename the original power board to the "Porcupine board"
2026-10-12 feat: add joint_test print and assembled joint view for case v2
    joint_test cuts short pieces from the real parts in one print: the bar
    dovetail (tab + notch), the mast socket, a short lower and upper mast
    piece (mast dovetail), and a short mast strip. joint_test_view shows the
    pieces fitted together (EXPLODE pulls them apart). Also adds a bed
    layout of all print parts (stl/plate_layout.scad) and its renders.
2026-10-12 fix: tighten case v2 dovetails and mast socket; add status notes
    - Dovetails were loose in the first joint_test: dt_clr 0.15 -> 0.05 and a
    crush rib on each slanted side of every tab (dt_rib 0.15)
    - Mast socket was loose: new sock_clr 0.1 (was the general 0.3 clearance)
    - README: status and next steps table, joint_test results
    - Add case/tools/overhang.py (support-free printing check)
2026-10-13 fix: open the bar cover over the IR LEDs; fit the Porcupine board
    - The first cover read "present" all the time: IR crossed the PLA web
    between the LED bores. New led_window setting: "slot" (default, one
    opening over both LEDs) or "tubes" (full-length tubes, dark PLA only).
    - ir_test prints one cover of each for the sensor_test body.
    - Porcupine board is 13.8 mm wide, not 15; the head's fences follow.
    - SENSOR_TEST flag in the sketch: no debounce and Serial logging for
    checking sensors (off by default).
    - README records the joint_test confirmation and these results.
2026-10-13 fix: let the IR LED tips stick out through the bar cover
    Every cover that kept the LED tips inside (bores, a slot, full-length
    tubes) read "present" all the time from reflections inside the cover.
    The tips now stick out 1.5 mm (led_out) through one slot, like the old
    case; the bar is 4.5 mm shallower. Drops the led_window options and
    ir_test.
2026-10-13 feat: publish pot state to ThingSpeak (ESP32)
    Sends an entry at boot and on each placed/removed change to channel
    3533214: field1-3 hold each pot's placed-at Unix time (0 unknown,
    -1 removed), status says what changed. Runs in its own FreeRTOS task
    over HTTPS, merges changes inside ThingSpeak's 15 s limit, and retries
    failures. Credentials go in the gitignored secrets.h (template:
    secrets.example.h); without it publishing is off.
2026-10-13 fix: rest the bar cover on the sensitivity screw so the LEDs stick out 4.6 mm
    LED tips 1.5 mm out still read "present" all the time. The old case had
    the board flat against the front, so the cover now rests on the
    sensitivity screw (pot_gap, no guide tube) and the LEDs stick out
    4.6 mm. The bar is 16.8 mm deep; the mast wire opening is shortened to
    stay under the cover rebate.
2026-10-13 docs: IR detection works through the case; pots sit on a rack
2026-10-13 feat: new LovyanGFX screen, OTA updates and a Netlify dashboard; drop the Nano
    - Screen (ui.cpp): header with clock and network icon, one row per pot
    with a large age, brew time, Fresh/OK/Old and a freshness bar. Drawn in
    sprites, so no flicker.
    - Drop Arduino Nano support and the Waveshare driver files.
    - OTA (ota.cpp): checks the Netlify site 2 min after boot and hourly,
    installs newer firmware over HTTPS, and keeps pot ages across the
    restart. The file name and site address live only in secrets.h.
    - Dashboard (dashboard/index.html) reading the ThingSpeak channel, and
    tools/build_netlify.sh to build the deploy zip.
    - ThingSpeak field4 carries the firmware version; partition schem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
2026-10-14 fix: give the HTTPS tasks 16 KB stacks; report the reset reason at boot
    The publish and OTA tasks had 8 KB stacks, likely too small for an HTTPS
    handshake: the board kept restarting within its first minute (stuck on
    the amber "connecting" icon) and never posted. The startup note now
    says why the board restarted, e.g. "Started v37 (crash)".
2026-10-14 feat: fix pot times from the dashboard via TalkBack; add tools/flash.sh
    - The board takes TalkBack commands every 20 s. "SET <pot> <unix time>"
    sets a pot's brew time if it's on the rack, and posts a note either way.
    - Dashboard: "Fix a pot's time" restores the brew time last reported
    before a restart, or sets one by hand. It appears only with the
    TalkBack key, taken from the share link (#key= or ?key=).
    - tools/flash.sh builds the Netlify zip and flashes that same firmware
    over USB, so the board never sits at version 0 and pulls an older build.
2026-10-14 feat: log firmware updates, failed updates and idle restarts
    The board records why it restarts itself in RTC memory. After an
    over-the-air update it posts "Updated v39 → v40" instead of a generic
    "Started" note, the weekend restart posts "Started vN (idle restart)",
    and a failed install posts "Update to vN failed (code)".
2026-10-14 docs: record the installed setup (BUNN pump airpots, wall mount, Wi-Fi)
    The pots are pump airpots, so they aren't lifted to pour: a placement
    is a refill or a cleaned pot (after hours). Case v2 is printed and
    mounted behind them. Drops the outdated sensor-rod plan.
